Wilko01/CV_Floor_Pump/Relase_notes.MD

# CV_Floor_Pump

## 2021-12-27 11:08
Copied and pasted the latest code in here
Changed the temperature levels of when to alert and switch the pump on and off
