Wilko01/CV_Floor_Pump/Images/ESPEasy_Config.jpg

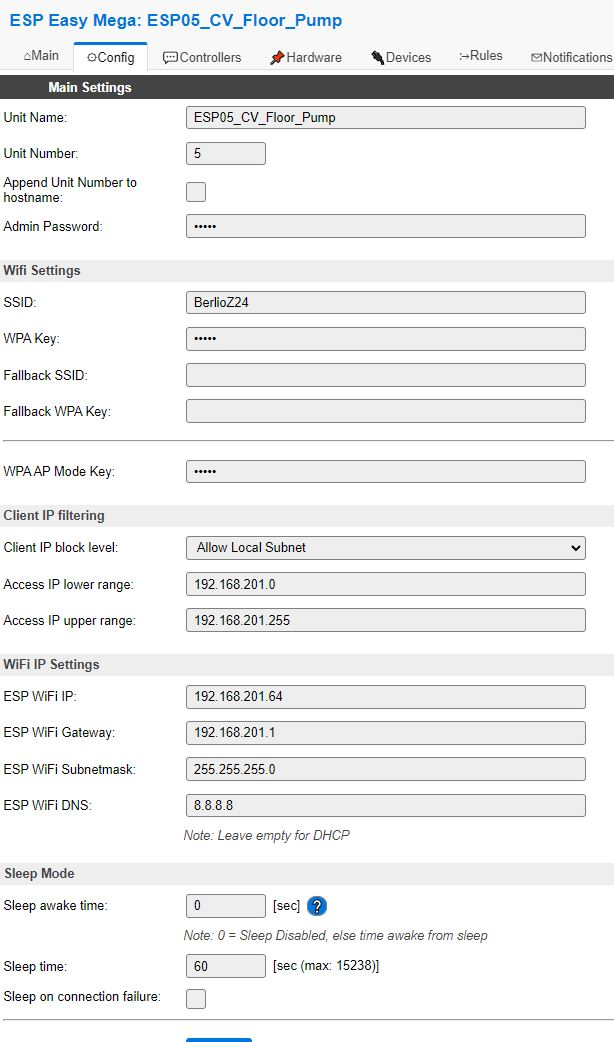
Images/ESPEasy_Config.jpg
