Wilko01/CV_Floor_Pump/Images/ESPEasy_Controller.jpg

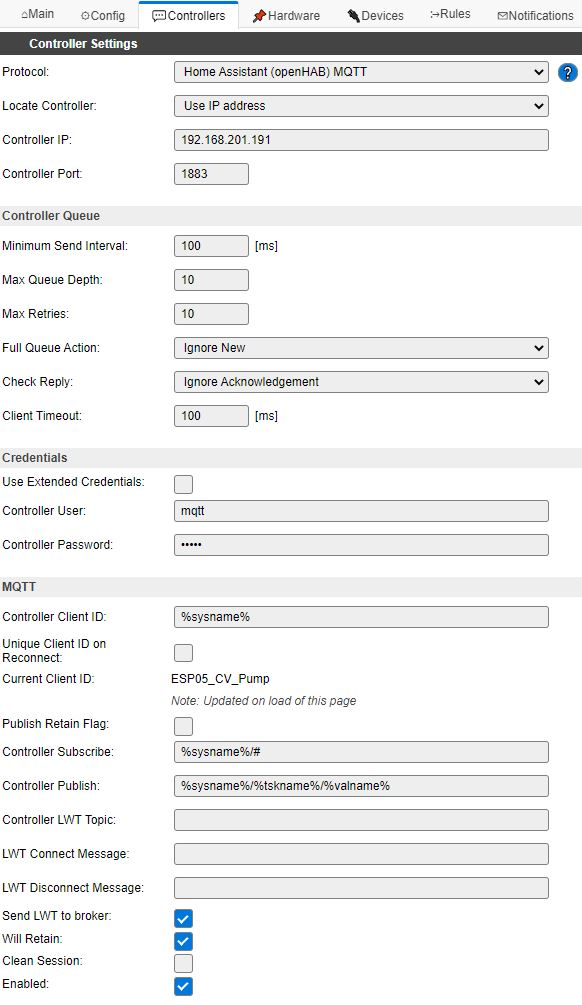
Images/ESPEasy_Controller.jpg
