Wilko01/CV_Floor_Pump/Images/ESPEasy_CV_Floor_Pump_Temp_In.jpg

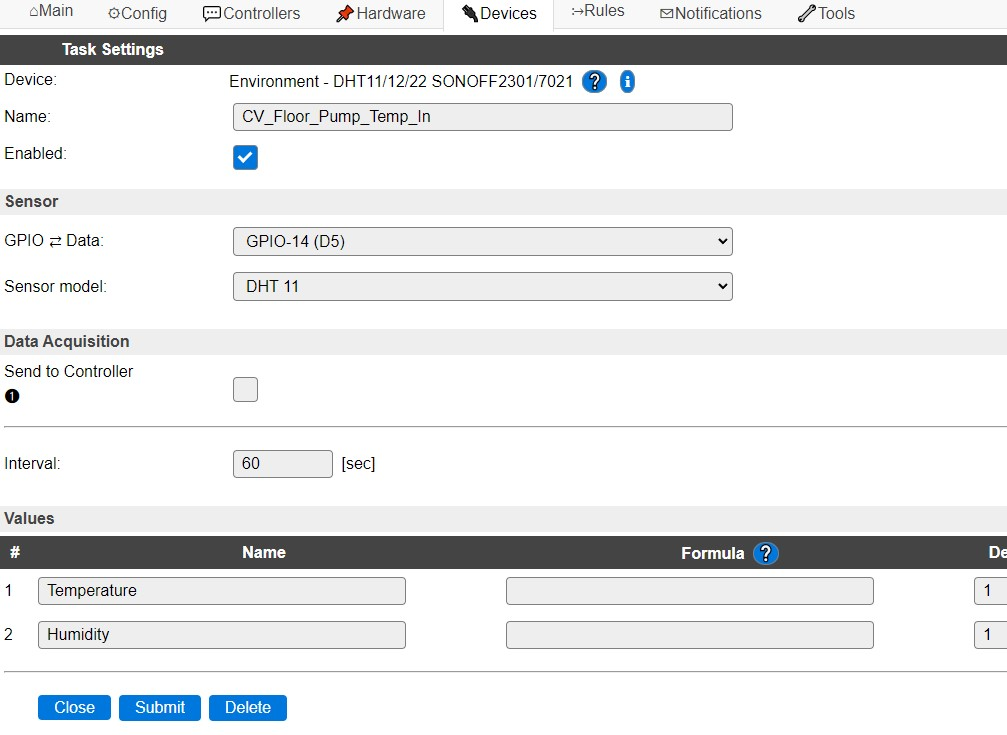
Images/ESPEasy_CV_Floor_Pump_Temp_In.jpg
