Wilko01/CV_Floor_Pump/Images/ESPEasy_Devices.jpg

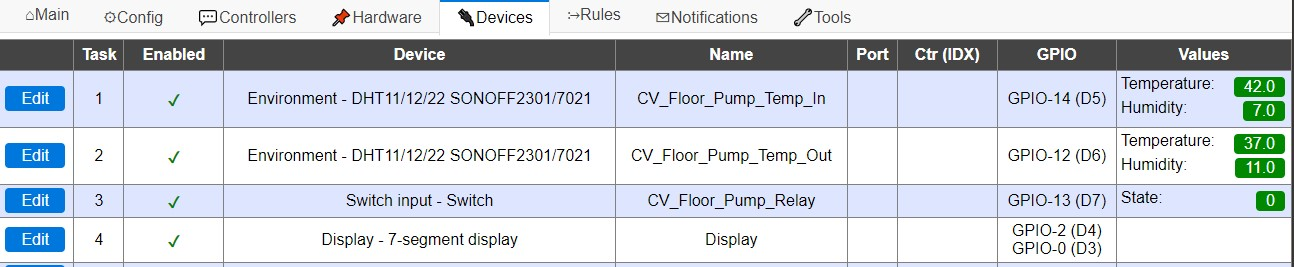
Images/ESPEasy_Devices.jpg
