Wilko01/CV_Floor_Pump/Images/ESPEasy_Display.jpg

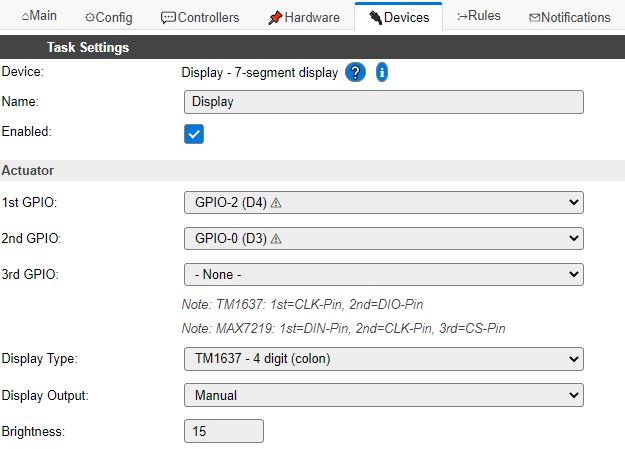
Images/ESPEasy_Display.jpg
