Wilko01/CV_Floor_Pump/(list of files, drawings)

Other design files:
CV_Floor_Pump.fzz
