Wilko01/CV_Floor_Pump/(commit log)

2021-09-20 Initial fill
    [CV_FloorPump.fzz]
2021-09-27 Added code to run once a day at a certain time
    [CV_FloorPump.fzz]
2021-10-02 Changed the names of the devices to be more logica
    [CV_Floor_Pump.fzz]
2022-08-13 set temp start to 27. the pump started in summer
2023-08-19 Added restart button
